judapies/Cabina-PCR/2019/CPCR 90 Artilab #004587978 OP201988/Schematic/Cabina_PCR - CADCAM Bottom Solder Resist.TXT

G04 PROTEUS RS274X GERBER FILE*
%FSLAX24Y24*%
%MOIN*%
%ADD26R,0.0700X0.0700*%
%ADD13C,0.0700*%
%ADD18C,0.1000*%
%ADD27C,0.0900*%
%ADD31R,0.1200X0.0800*%
%ADD28C,0.1500*%
%ADD29R,0.1000X0.1000*%
%ADD72C,0.2900*%
%ADD73R,0.2200X0.2200*%
%ADD32R,0.0850X0.1400*%
%ADD30C,0.1300*%
%ADD12C,0.0800*%
%ADD70C,0.0080*%
G54D26*
X+16102Y+9133D03*
G54D13*
X+17102Y+9133D03*
X+18102Y+9133D03*
X+19102Y+9133D03*
X+20102Y+9133D03*
X+21102Y+9133D03*
X+22102Y+9133D03*
X+23102Y+9133D03*
X+24102Y+9133D03*
X+25102Y+9133D03*
X+26102Y+9133D03*
X+27102Y+9133D03*
X+28102Y+9133D03*
X+29102Y+9133D03*
X+30102Y+9133D03*
X+31102Y+9133D03*
X+32102Y+9133D03*
X+33102Y+9133D03*
X+34102Y+9133D03*
X+35102Y+9133D03*
X+35102Y+15133D03*
X+34102Y+15133D03*
X+33102Y+15133D03*
X+32102Y+15133D03*
X+31102Y+15133D03*
X+30102Y+15133D03*
X+29102Y+15133D03*
X+28102Y+15133D03*
X+27102Y+15133D03*
X+26102Y+15133D03*
X+25102Y+15133D03*
X+24102Y+15133D03*
X+23102Y+15133D03*
X+22102Y+15133D03*
X+21102Y+15133D03*
X+20102Y+15133D03*
X+19102Y+15133D03*
X+18102Y+15133D03*
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
