judapies/Cabina-PCR/2019/CPCR 90 Artilab #004587978 OP201988/Materiales/Listado de Componentes Cabina de Flujo.xlsx

Sheet: Parte Electronica 110V
Cabina Flujo Vertical 110V
Descripción | Referencia | Cantidad | Sitio de Compra | Dirección
OptoTriac | MOC3041 | 3 | Sanyvi Electronics | Cra 9 # 19-30 LOC:212
Triac | BTA-16 | 3 | Sanyvi Electronics | Cra 9 # 19-30 LOC:212
Borneras | 2 Pines Verdes | 5 | Sanyvi Electronics | Cra 9 # 19-30 LOC:212
Conectores GP (con uñas) | 8 Pines | 1 | Sanyvi Electronics | Cra 9 # 19-30 LOC:212
 | 16 Pines | 2 | Sanyvi Electronics | Cra 9 # 19-30 LOC:212
Fusible Corto | 2 A. | 1 | Sanyvi Electronics | Cra 9 # 19-30 LOC:212
Portafusible pequeño para impreso | Con tapa negra | 1 | Sanyvi Electronics | Cra 9 # 19-30 LOC:212
Reostato | 10K | 1 | Sanyvi Electronics | Cra 9 # 19-30 LOC:212
Cristal de Cuarzo | 4MHz | 1 | Sanyvi Electronics | Cra 9 # 19-30 LOC:212
Resistencias 1/4W | 10K | 6 | Sanyvi Electronics | Cra 9 # 19-30 LOC:212
 | 1K | 5 | Sanyvi Electronics | Cra 9 # 19-30 LOC:212
 | 330R | 3 | Sanyvi Electronics | Cra 9 # 19-30 LOC:212
Condensador | 10uF/16V | 1 | Sanyvi Electronics | Cra 9 # 19-30 LOC:212
 | 100nF (104) Monolitico | 1 | Sanyvi Electronics | Cra 9 # 19-30 LOC:212
 | 22pF | 2 | Sanyvi Electronics | Cra 9 # 19-30 LOC:212
Display LCD | 4X20 Azul | 1 | Sanyvi Electronics | Cra 9 # 19-30 LOC:212
Varistor | 20D241K | 1 | Sanyvi Electronics | Cra 9 # 19-30 LOC:212
Microcontrolador | PIC 18F4550 | 1 | Sanyvi Electronics | Cra 9 # 19-30 LOC:212
Regleta Profesional | 40 pines | 3 | Sanyvi Electronics | Cra 9 # 19-30 LOC:212
Poste plastico | Para sujecion de tarjeta | 4 | Sanyvi Electronics | Cra 9 # 19-30 LOC:212
Botones | Tipo huevo blanco | 4 | Sanyvi Electronics | Cra 9 # 19-30 LOC:212
Transistor | 2N3904 | 1 | Sanyvi Electronics | Cra 9 # 19-30 LOC:212
Led Rojo | 5mm | 1 | Sanyvi Electronics | Cra 9 # 19-30 LOC:212
Buzzer redondo para impreso | 5V | 1 | Sanyvi Electronics | Cra 9 # 19-30 LOC:212
Interruptor ON-OFF redondo | 20mm Negro sin piloto | 1 | Sanyvi Electronics | Cra 9 # 19-30 LOC:212
Fuente 5VDC 4A Para impreso | IRM-20-5 | 1 | Sigma Electronica Ltda | Av. Cra 24 No 61D-65

Sheet: Parte Electrica 110V
Cabina Flujo Horizontal 110V
Descripción | Referencia | Cantidad | Precio Unitario | Precio Total
Breaker CHINT 1 polo | 2A | 1 | $10000 | $10000
Interruptor de balancin redondo | 20mm | 1 | $3000 | $3000
Regleta de polietileno | 30A | 1 | $4500 | $4500
Prensacable | PG11 | 4 | $800 | $3200
Cable Encauchetado Conalcables | 3X12 | 4 | $4500 | $18000
Clavija | 110V 15A Leviton | 1 | $6500 | $6500
 |  |  |  | $45200 | TOTAL

Sheet: Hoja1
 | Cabina Flujo Vertical 220V
 | Descripción | Referencia | Cantidad
 | OptoTriac | MOC3021 | 6
 | Triac | BT137 | 2
 |  | BTA-16 | 4
 | Borneras | 2 Pines Verdes | 7
 |  | 3 Pines Verde | 1
 | Conectores GP (con uñas) | 5 Pines | 1
 |  | 16 Pines | 2
 | Puente Rectificador | Redondo 1A | 1
 | Regulador de Voltaje | LM7805 | 1
 | Reostato | 10K | 1
 | Cristal de Cuarzo | 4MHz | 1
 | Resistencias 1/4W | 10K | 6
 |  | 1K | 6
 |  | 330R | 6
 | Condensador | 470uF/25V | 1
 |  | 10uF/16V | 3
 |  | 100nF (104) | 2
 |  | 22pF | 2
 | Display | 4X20 | 1
 | Microcontrolador | PIC 18F4550 | 1
 | Terminales | Según muestra | 8
 | Breaker CHINT 2 polos | 2A | 1
 | Breaker CHINT 1 polo | 10A | 1
 | Interruptor de balancin redondo | 20mm | 1
 | Toma doble blanca | Leviton | 1
 | Tapa de seguridad para toma doble | Plastica gris | 1
 | Regleta de polietileno | 15A | 1
 | Prensacable | PG11 | 4
 | Cable Encauchetado Conalcables | 4X12 | 3m
Ingenieros | Faiver H. Trujillo G | Juan David Piñeros E | 2014- Abr-15
