judapies/Cabina-PCR/2019/CPCR 90 Artilab #004587978 OP201988/SGC/REQUISICION DE MATERIALES CABINA DE FLUJO LAMINAR HORIZONTAL.xlsx

Sheet: Formato requisiones
JP BIOINGENIERIA S.A.S |  |  | REQUISICION DE MATERIALES |  |  |  |  |  |  |  | FJP - 35
 |  |  |  |  |  |  |  |  |  |  | Version 01
Efectivo a partir de: 20 Dic 2017 |  |  |  |  |  | Documento de origen: DJP- 24 |  |  |  |  | Pág. 1 de 1
FECHA | 10 | 7 | 2019
PRODUCTO: | CABINA DE PCR 90 |  |  |  |  |  |  | Orden de Pedido No. |  |  | 201988
 |  |  |  |  |  |  |  | Visita Técnica:
DESCRIPCION |  |  |  |  |  | Referencia |  |  | CANTIDAD REQUERIDA
Tarjeta PCR |  |  |  |  |  | DIELEC |  |  | 1
FUENTE DE PODER |  |  |  |  |  | IRM 20-5 |  |  | 1
Resistencias (1/4W) |  |  |  |  |  | 10K |  |  | 6
Resistencias (1/4W) |  |  |  |  |  | 330Ω |  |  | 3
Resistencias (1/4W) |  |  |  |  |  | 1K | 1K | 1K | 5 | 10 | 10 | 10
Reóstato | Reóstato | Reóstato | Reóstato | Reóstato | Reóstato | 10K (pequeño) | 10K (pequeño) | 10K (pequeño) | 1 | 2 | 2 | 2
Condensadores | Condensadores | Condensadores | Condensadores | Condensadores | Condensadores | Condensador 104 tantalio | 0.1 uF Monolitico | 0.1 uF Monolitico | 1 | 28 | 28 | 28
Condensadores | Condensadores | Condensadores | Condensadores | Condensadores | Condensadores | 22 pF Ceramico | 22 pF Ceramico | 22 pF Ceramico | 2 | 4 | 4 | 4
Buzzer | Condensadores | Condensadores | Condensadores | Condensadores | Condensadores | 5 a 12v | 470 µF @ 16V | 470 µF @ 16V | 1 | 2 | 2 | 2
Condensadores | Condensadores | Condensadores | Condensadores | Condensadores | Condensadores | 10 µF @ 16V | 10 µF @ 16V | 10 µF @ 16V | 1 | 2 | 2 | 2
Cristal | Cristal | Cristal | Cristal | Cristal | Cristal | 4MHz | 4MHz | 4MHz | 1 | 2 | 2 | 2
Pantalla LCD. Azul | Pantalla LCD. Azul | Pantalla LCD. Azul | Pantalla LCD. Azul | Pantalla LCD. Azul | Pantalla LCD. Azul | 4X20 | 2X16 | 2X16 | 1 | 2 | 2 | 2
Conector GP (Con uñas) | Conector GP (Con uñas) | Conector GP (Con uñas) | Conector GP (Con uñas) | Conector GP (Con uñas) | Conector GP (Con uñas) | 16P | 2P | 2P | 2 | 4 | 4 | 4
Conector GP (Con uñas) | Conector GP (Con uñas) | Conector GP (Con uñas) | Conector GP (Con uñas) | Conector GP (Con uñas) | Conector GP (Con uñas) | 8P | 3P | 3P | 1 | 6 | 6 | 6
Regleta profesional | Regleta profesional | Regleta profesional | Regleta profesional | Regleta profesional | Regleta profesional | 1X40 | 1X40 | 1X40 | 1 | 2 | 2 | 2
Transistor | Transistor | Transistor | Transistor | Transistor | Transistor | 2N3904 | 2N3904 | 2N3904 | 1 | 2 | 2 | 2
Bornera | Bornera | Bornera | Bornera | Bornera | Bornera | 2 pines Verde | 2 pines Verde | 2 pines Verde | 5 | 2 | 2 | 2
Botones | Botones | Botones | Botones | Botones | Botones | Tipo huevo blanco | Tipo huevo blanco | Tipo huevo blanco | 4 | 6 | 6 | 6
Led para piloto 5mm | Led para piloto 5mm | Led para piloto 5mm | Led para piloto 5mm | Led para piloto 5mm | Led para piloto 5mm | Rojo | Chorro | Chorro | 1 | 2 | 2 | 2
Interruptor redondo | Interruptor redondo | Interruptor redondo | Interruptor redondo | Interruptor redondo | Interruptor redondo | on/off | con piloto | con piloto | 1 | 2 | 2 | 2
Portafusible Corto | Portafusible largo | Portafusible largo | Portafusible largo | Portafusible largo | Portafusible largo | para impreso | Para Chasis | Para Chasis | 1 | 2 | 2 | 2
fusible | fusible | fusible | fusible | fusible | fusible | 2A | 250 mA | 250 mA | 1 | 2 | 2 | 2
Optocoplador | Conector DB25 para impreso | Conector DB25 para impreso | Conector DB25 para impreso | Conector DB25 para impreso | Conector DB25 para impreso | MOC 3041 | Macho | Macho | 3 | 2 | 2 | 2
Triac | Extensión DB25 | Extensión DB25 | Extensión DB25 | Extensión DB25 | Extensión DB25 | BT137 | Macho-Hembra | Macho-Hembra | 3 | 2 | 2 | 2
Sensor de presion | Puntas de Multímetro | Puntas de Multímetro | Puntas de Multímetro | Puntas de Multímetro | Puntas de Multímetro | MPXV5004DP | Negras | Negras | 1 | 2 | 2 | 2
Switch Magnetico Blanco | Puntas de Multímetro | Puntas de Multímetro | Puntas de Multímetro | Puntas de Multímetro | Puntas de Multímetro | Con iman | Negras | Negras | 1 | 2 | 2 | 2
Breaker chint un polo | Bananas para puntas | Bananas para puntas | Bananas para puntas | Bananas para puntas | Bananas para puntas | 10A | Negras | Negras | 1 | 4 | 4 | 4
Contactor chint | Banana Negra | Banana Negra | Banana Negra | Banana Negra | Banana Negra | 9A | Hembra | Hembra | 1 | 2 | 2 | 2
Clavija levinton amarilla | Conector USB TipoB | Conector USB TipoB | Conector USB TipoB | Conector USB TipoB | Conector USB TipoB | 15A 125V | Pines atrás | Pines atrás | 1 | 2 | 2 | 2
Microcontrolador | Microcontrolador | Microcontrolador | Microcontrolador | Microcontrolador | Microcontrolador | PIC 18F4550 | PIC 18F4550 | PIC 18F4550 | 1 | 2 | 2 | 2
Poste plastico | Poste plastico | Poste plastico | Poste plastico | Poste plastico | Poste plastico | Para sujecion de tarjeta | Para sujecion de tarjeta | Para sujecion de tarjeta | 4 | 8 | 8 | 8
Toma Doble 110V |  |  |  |  |  | Hidrobox |  |  | 2
Luz UV |  |  |  |  |  | 15W |  |  | 2
Luces |  |  |  |  |  | Led blanca |  |  | 1
Balastro |  |  |  |  |  | 2X32W ;120-227V |  |  | 1
CANALETA |  |  |  |  |  | CANALETA RANURADA |  |  | 1MT
Frenos | PortaLED | PortaLED | PortaLED | PortaLED | PortaLED | Frenos riel omega | Para LED de 5mm | Para LED de 5mm | 2 | 10 | 10 | 10
CABLE |  |  |  |  |  | CABLE 8X22 |  |  | 1,30MTS
CABLE VEHICULAR L Y N |  |  |  |  |  | CABLE #18 |  |  | 60 CMS
CABLE VEHICULAR L Y N |  |  |  |  |  | CABLE #18 |  |  | 1 MTS
CABLE VEHICULAR L Y N |  |  |  |  |  | CABLE #18 |  |  | 1,10MTS
CABLE |  |  |  |  |  | CABLE 2X18 |  |  | 1,15MTS
CABLE |  |  |  |  |  | CABLE 16X22 |  |  | 1,30 MTS
CABLE |  |  |  |  |  | CABLE 3X14 |  |  | 6 MTS
TERMINALES |  |  |  |  |  | Tipo O amarilla |  |  | 2
TERMINALES |  |  |  |  |  | Tipo fastor azul |  |  | 2
TERMINALES |  |  |  |  |  | Tipo bala hembra azul |  |  | 2
TERMINALES |  |  |  |  |  | Tipo bala macho azul |  |  | 2
TERMINALES |  |  |  |  |  | Tipo bala hembra rojas |  |  | 10
TERMINALES |  |  |  |  |  | Tipo bala macho rojas |  |  | 10
Caja de Paso Plastica |  |  |  |  |  | K2121-116 |  |  | 0
Riel omega |  |  |  |  |  | Riel |  |  | 10 cm
SOLICITADO POR: |  |  |  | ENTREGADO POR: |  |  |  | RECIBIDO POR:

Sheet: Informe de compatibilidad
Informe de compatibilidad para FJP- 35 REQUISICION DE MATERIALES.XLS
Ejecutar el 10/05/2018 8:41
Las siguientes características de este libro no son compatibles con versiones anteriores de Excel. Estas características podrían perderse o degradarse si abre el libro con una versión anterior de Excel o si guarda el libro con un formato de archivo anterior.
Pérdida menor de fidelidad | Nº de apariciones | Versión
Algunas celdas o estilos de este libro contienen un formato no admitido en el formato de archivo seleccionado. Estos formatos se convertirán al formato más cercano disponible. | 1 | Excel 97-2003
