judapies/Cabina-PCR/2019/CPCR60 GLCD Avantika  #004588033-40 OP2019156-161_181-182/SGC/FJP- 35  REQUISICION DE MATERIALES CFLH-V GLCD.xlsx

JP BIOINGENIERIA S.A.S |  |  | REQUISICION DE MATERIALES |  |  |  |  |  |  |  | FJP - 35
 |  |  |  |  |  |  |  |  |  |  | Version 01
Efectivo a partir de: 20 Dic 2017 |  |  |  |  |  | Documento de origen: DJP- 24 |  |  |  |  | Pág. 1 de 1
FECHA | 13 | 11 | 2019
PRODUCTO: | CPCR24 |  |  |  |  |  |  | Orden de Pedido No.
 |  |  |  |  |  |  |  | Visita Técnica:
DESCRIPCION |  |  |  |  |  | Referencia |  |  | CANTIDAD REQUERIDA
Tarjeta de control |  |  |  |  |  | DIELEC-CFLH-V0015 |  |  | 1
Resistencias Montaje Superficial 0805 |  |  |  |  |  | 470Ω |  |  | 1
Resistencias Montaje Superficial 0805 |  |  |  |  |  | 10k |  |  | 7
Resistencias Montaje Superficial 0805 |  |  |  |  |  | 1k |  |  | 6
Resistencias (1W) |  |  |  |  |  | 15k |  |  | 2
Resistencias (1W) |  |  |  |  |  | 39Ω |  |  | 1
Resistencias (1W) |  |  |  |  |  | 360Ω |  |  | 1
Resistencias (1W) |  |  |  |  |  | 470Ω |  |  | 1
Condensador de Poliester | Reóstato | Reóstato | Reóstato | Reóstato | Reóstato | 103/600V | 10K (pequeño) | 10K (pequeño) | 1 | 2 | 2 | 2
Condensador de Poliester | Reóstato | Reóstato | Reóstato | Reóstato | Reóstato | 50nF/600V | 10K (pequeño) | 10K (pequeño) | 1 | 2 | 2 | 2
Condensador de tantalio SMD | Condensadores | Condensadores | Condensadores | Condensadores | Condensadores | 0,1uF | 10 µF @ 16V | 10 µF @ 16V | 5
Condensador Ceramico | Condensadores | Condensadores | Condensadores | Condensadores | Condensadores | 22pF | 10 µF @ 16V | 10 µF @ 16V | 2
Cristal de Quarzo | Cristal | Cristal | Cristal | Cristal | Cristal | 20MHz | 4MHz | 4MHz | 1
Regleta Macho | Conector GP (Con uñas) | Conector GP (Con uñas) | Conector GP (Con uñas) | Conector GP (Con uñas) | Conector GP (Con uñas) | 1X40 | 2P | 2P | 1
Conector GP (Con uñas) | Conector GP (Con uñas) | Conector GP (Con uñas) | Conector GP (Con uñas) | Conector GP (Con uñas) | Conector GP (Con uñas) | 8P | 5P | 5P | 1
Regleta Hembra | Conector GP (Con uñas) | Conector GP (Con uñas) | Conector GP (Con uñas) | Conector GP (Con uñas) | Conector GP (Con uñas) | 1x40 | 5P | 5P | 1
Regleta profesional | Regleta profesional | Regleta profesional | Regleta profesional | Regleta profesional | Regleta profesional | 1X40 | 1X40 | 1X40 | 2
Optocoplador |  |  |  |  |  | MOC3021 |  |  | 1
Triac |  |  |  |  |  | BT139 |  |  | 1
Transistor Montaje Superficial |  |  |  |  |  | MMBT2222A |  |  | 4
Puente Rectificador Montaje Superficial |  |  |  |  |  | DF02S |  |  | 1
Elevador de Voltaje | Regulador 5V | Regulador 5V | Regulador 5V | Regulador 5V | Regulador 5V | MT3608 | LM 7805 | LM 7805 | 0
Fuente Conmutada para PCB | Puente Rectificador | Puente Rectificador | Puente Rectificador | Puente Rectificador | Puente Rectificador | IRM-20-5 | Redondo 1.5A | Redondo 1.5A | 1 | 2 | 2 | 2
Interruptor Redondo | Puente Rectificador | Puente Rectificador | Puente Rectificador | Puente Rectificador | Puente Rectificador | ON-OFF Negro | Redondo 1.5A | Redondo 1.5A | 1 | 2 | 2 | 2
Borneras | Bornera | Bornera | Bornera | Bornera | Bornera | 2 pines Verde | 2 pines Verde | 2 pines Verde | 9 | 2 | 2 | 2
Botones | Botones | Botones | Botones | Botones | Botones | Tipo huevo blanco | Tipo huevo blanco | Tipo huevo blanco | 4 | 6 | 6 | 6
Sensor de Presion | Botones | Botones | Botones | Botones | Botones | MPXV5004DP | Tipo huevo blanco | Tipo huevo blanco | 1 | 6 | 6 | 6
Buzzer | Buzzer | Buzzer | Buzzer | Buzzer | Buzzer | 5V ó 12V | 5V a 12V | 5V a 12V | 1 | 2 | 2 | 2
Diodo Montaje Superficial |  |  |  |  |  | FM4004 |  |  | 1
Led 0805 |  |  |  |  |  | Rojo o Verde o Azul |  |  | 1
Disipador con pines para soldar |  |  |  |  |  | Grande |  |  | 1
Reostato pequeño |  |  |  |  |  | 10k |  |  | 1
Portafusible para impreso |  |  |  |  |  | Con Tapa |  |  | 1
Fusible Corto |  |  |  |  |  | 4A |  |  | 1
Microcontrolador | Microcontrolador | Microcontrolador | Microcontrolador | Microcontrolador | Microcontrolador | PIC 18F4685 | PIC 18F4550 | PIC 18F4550 | 1 | 2 | 2 | 2
Display GLCD | Microcontrolador | Microcontrolador | Microcontrolador | Microcontrolador | Microcontrolador | 128x64 px Azul | PIC 18F4550 | PIC 18F4550 | 1 | 2 | 2 | 2
Switch Magnetico |  |  |  |  |  | Para posicion de Vidrio |  |  | 1
Iman para Switch Magnetico |  |  |  |  |  | Para posicion de Vidrio |  |  | 1
Optocoplador |  |  |  |  |  | PC817 |  |  | 1
Rele de Estadoo Solido para impreso |  |  |  |  |  | G3MB-202P |  |  | 1
Sensor de Temperatura |  |  |  |  |  | LM35 |  |  | 1
Breaker unipolar CHINT 4A |  |  |  |  |  | 09606 |  |  | 1
Breaker unipolar CHINT 10A |  |  |  |  |  | 09610 |  |  | 1
Riel |  |  |  |  |  | Omega |  |  | 15cm
Frenos para riel omega |  |  |  |  |  |  |  |  | 2
Pasacable |  |  |  |  |  | PG11
Pasacable |  |  |  |  |  | PG13,5
Clavija Leviton Amarilla |  |  |  |  |  | 115VAC/15A |  |  | 1
Toma |  |  |  |  |  | Hidrobox |  |  | 2
Modulo |  |  |  |  |  | Hidrobox |  |  | 2
Terminal |  |  |  |  |  | Tipo Bala hembra (roja)
Terminal |  |  |  |  |  | Tipo Bala Macho(roja)
Terminal |  |  |  |  |  | Tipo Bala hembra (Azul)
Terminal |  |  |  |  |  | Tipo Bala Macho (Azul)
Terminal |  |  |  |  |  | Tipo ojo (Amarilla)
Terminal |  |  |  |  |  | Tipo Faston (Azul)
Bornera plastica |  |  |  |  |  | 15A
Luz led |  |  |  |  |  |  |  |  | 2
Luz UV Germicida |  |  |  |  |  | 15W |  |  | 2
Balastro Multivoltaje |  |  |  |  |  | 2X32W |  |  | 1
Cable (sensor flujo) |  |  |  |  |  | Blindado 6x22
Cable (sensor vidrio) |  |  |  |  |  | Blindado 6x22
Cable (Botones) |  |  |  |  |  | Blindado 8x22
Cable (toma) |  |  |  |  |  | Encauchetado 3x14
Cable (Alimentacion) |  |  |  |  |  | Encauchetado 3x14
Cable (Motores) |  |  |  |  |  | Encauchetado 3x18
Cable (Luz blanca) |  |  |  |  |  | Encauchetado 2x18
Cable (Luz UV) |  |  |  |  |  | Encauchetado 2x18
SOLICITADO POR: |  |  |  | ENTREGADO POR: |  |  |  | RECIBIDO POR:
