judapies/Cabina-PCR/2017/60/Cabina Avantika #004587687/Schematic/Cabina_PCR.DXF

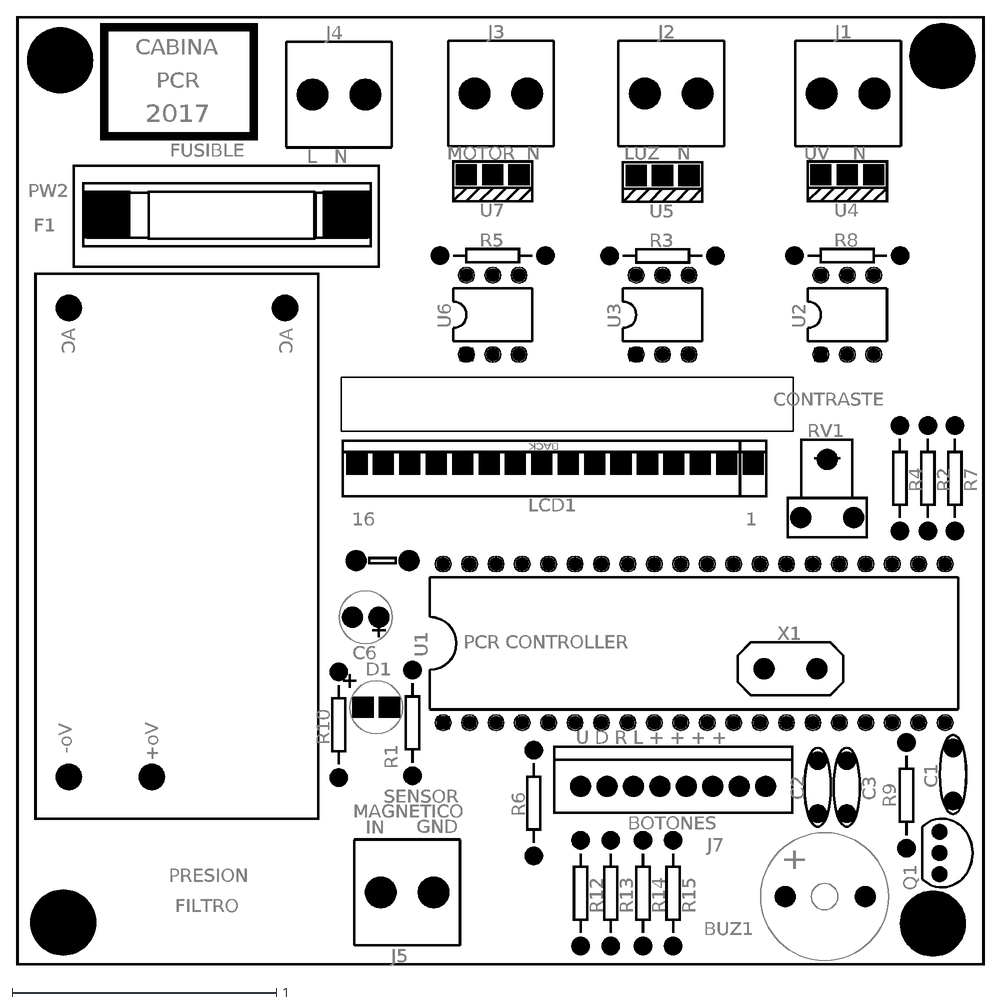
[picture p1: CAD file, 2021-07-15]
2017/60/Cabina Avantika #004587687/Schematic/Cabina_PCR.DXF
U1
J7
R12
R13
R14
R15
R6
J5
R1
C1
BACK
LCD1
RV1
X1
C2
C3
J4
R7
R2
R3
R4
U2
U3
U6
R8
R5
U4
U5
U7
J1
J2
J3
F1
CABINA
PCR
2017
C6
AC
Vo+
Vo-
PW2
PCR CONTROLLER
BOTONES
U D R L + + + +
SENSOR
MAGNETICO
IN
GND
PRESION
FILTRO
1
16
CONTRASTE
FUSIBLE
L N
MOTOR N
UV N
LUZ N
+
BUZ1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
