judapies/Cabina-PCR/2019/CPCR 90 Universidad Nariño LCD4X20 #004588059 OP2019205/Schematic/User Library-LCD 4X20.IGS

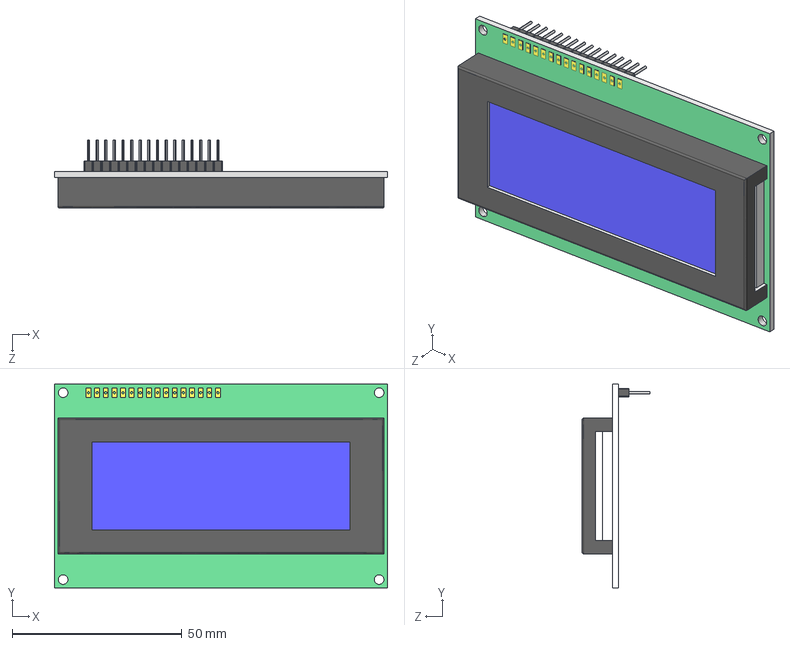
[picture p2: CAD file, 2021-07-15]
2019/CPCR 90 Universidad Nariño LCD4X20 #004588059 OP2019205/Schematic/User Library-LCD 4X20.IGS
98.0 x 60.0 x 20.0 mm
