judapies/Cabina-PCR/(list of files, cad)

Other CAD files:
2015/Microvet/Plano Electrico/Mini-Cabina 110VAC/Distribucion de conexiones.dwg
2015/Microvet/Plano Electrico/Plano_Electrico_Cabina_Flujo_Vertical/Distribución de Conexiones.dwg
2017/60/Cabina Avantika #004587687/Plano Electrico/Plano Electrico Cabina PCR/ConexionesElectricasYElectronicas.dwg
2017/60/Cabina Punto Clinico #004587647/Plano Electrico/Plano Electrico Cabina PCR/ConexionesElectricasYElectronicas.dwg
2019/CPCR 90 Artilab #004587978 OP201988/Plano Electrico/Plano Electrico Cabina CFLH/ConexionesElectricasYElectronicas.dwg
2019/CPCR 90 Artilab #004587987 OP201994/Plano Electrico/Plano Electrico Cabina CFLH/ConexionesElectricasYElectronicas.dwg
2019/CPCR 90 Universidad Nariño LCD4X20 #004588059 OP2019205/Plano Electrico/Plano Electrico Cabina CFLH/ConexionesElectricasYElectronicas.dwg
2019/CPCR60 GLCD Avantika #004588033-40 OP2019156-161_181-182/Plano Electrico CPCR GLCD/Conexiones_Panel_Control CPCR.dwg
2019/CPCR90 GLCD Artilab #004587996 OP2019116/Plano Electrico CPCR GLCD/Conexiones_Panel_Control CPCR.dwg
2020/CPCR 48 Laboratorio Garcia Beltran LCD4X20 #004588177 OP202083/Plano Electrico/Plano Electrico Cabina CFLH/ConexionesElectricasYElectronicas.dwg
2020/CPCR Trabajo Annar D4X20 #004588213-14-36-37 OP2020200-203/Plano Electrico/Plano Electrico Estacion PCR/ConexionesElectricasYElectronicas.dwg
2020/CPCR Trabajo Annar D4X20 #004588267-68-69-70-71-72-73 OP2020231-232-233-234-235-244-245/Plano Electrico/Plano Electrico Estacion PCR/ConexionesElectricasYElectronicas.dwg
2020/CPCR Trabajo Annar D4X20 #0045882XX-XX-XX-XX-XX OP2020265-266-267-268-269/Plano Electrico/Plano Electrico Estacion PCR/ConexionesElectricasYElectronicas.dwg
2020/CPCR Trabajo Artilab D4X20 #004588179 OP2020157/Plano Electrico/Plano Electrico Estacion PCR/ConexionesElectricasYElectronicas.dwg
2020/CPCR Trabajo Avantika D4X20 #0045882XX-XX OP2020226-227/Plano Electrico/Plano Electrico Estacion PCR/ConexionesElectricasYElectronicas.dwg
2020/CPCR Trabajo Avantika D4X20 #004588337-48 OP2020305-306/Plano Electrico/Plano Electrico Estacion PCR/ConexionesElectricasYElectronicas.dwg
2020/CPCR Trabajo Biodiz D4X20 #004588392 OP2020357/Plano Electrico/Plano Electrico Estacion PCR/ConexionesElectricasYElectronicas.dwg
2020/CPCR Trabajo Clinica Los Nogales D4X20 #004588205 OP2020163/Plano Electrico/Plano Electrico Estacion PCR/ConexionesElectricasYElectronicas.dwg
2020/CPCR Trabajo Colcan D4X20 #004588219-20-21-22-23-24 OP2020186-91/Plano Electrico/Plano Electrico Estacion PCR/ConexionesElectricasYElectronicas.dwg
2020/CPCR Trabajo Colcan D4X20 #0045882XX-XX-XX-XX-XX OP2020265-266-267-268-269 - copia/Plano Electrico/Plano Electrico Estacion PCR/ConexionesElectricasYElectronicas.dwg
2020/CPCR Trabajo Kasai D4X20 #004588185 OP2020164/Plano Electrico/Plano Electrico Estacion PCR/ConexionesElectricasYElectronicas.dwg
2020/CPCR Trabajo Laboratorio Hormonal D4X20 #004588180 OP2020160/Plano Electrico/Plano Electrico Estacion PCR/ConexionesElectricasYElectronicas.dwg
2020/CPCR Trabajo Labserving D4X20 #0045882XX OP2020223/Plano Electrico/Plano Electrico Estacion PCR/ConexionesElectricasYElectronicas.dwg
2020/CPCR Trabajo Lorena Vejarano D4X20 #004588135 OP2020109/Plano Electrico/Plano Electrico Estacion PCR/ConexionesElectricasYElectronicas.dwg
2020/CPCR Trabajo Lorena Vejarano D4X20 #004588136 OP2020110/Plano Electrico/Plano Electrico Estacion PCR/ConexionesElectricasYElectronicas.dwg
2020/CPCR Trabajo Lorena Vejarano D4X20 #004588210 OP2020180/Plano Electrico/Plano Electrico Estacion PCR/ConexionesElectricasYElectronicas.dwg
2020/CPCR Trabajo Lorena Vejarano D4X20 #004588211 OP2020179/Plano Electrico/Plano Electrico Estacion PCR/ConexionesElectricasYElectronicas.dwg
2020/CPCR Trabajo Prime Diagnostics D4X20 #004588391-57 OP2020348-349/Plano Electrico/Plano Electrico Estacion PCR/ConexionesElectricasYElectronicas.dwg
2020/CPCR180 GLCD Diagnostic Medical Lab #004588393 OP2020308/Plano Electrico CPCR GLCD/Conexiones_Panel_Control CPCR.dwg
2020/CPCR60 GLCD Laboratorio Clinico Kheneyder Fayad #004588294 OP2020276/Plano Electrico CPCR GLCD/Conexiones_Panel_Control CPCR.dwg
2020/CPCR60 GLCD Avantika #004588102 OP202046/Plano Electrico CPCR GLCD/Conexiones_Panel_Control CPCR.dwg
2020/CPCR60 GLCD Avantika #004588103 OP202047/Plano Electrico CPCR GLCD/Conexiones_Panel_Control CPCR.dwg
2020/CPCR60 GLCD Avantika #004588100 OP202044/Plano Electrico CPCR GLCD/Conexiones_Panel_Control CPCR.dwg
2020/CPCR60 GLCD Avantika #004588101 OP202045/Plano Electrico CPCR GLCD/Conexiones_Panel_Control CPCR.dwg
2020/CPCR60 GLCD CEMMIT #004588404 OP2020359/Plano Electrico CPCR GLCD/Conexiones_Panel_Control CPCR.dwg
2020/CPCR90 GLCD Artilab #004588091 OP2019199/Plano Electrico CPCR GLCD/Conexiones_Panel_Control CPCR.dwg
2020/CPCR90 GLCD Avantika #004588183 OP2020140/Plano Electrico CPCR GLCD/Conexiones_Panel_Control CPCR.dwg
2020/CPCR90 GLCD Avantika #004588186-87 OP2020154-155/Plano Electrico CPCR GLCD/Conexiones_Panel_Control CPCR.dwg
2020/CPCR90 GLCD Avantika #004588212 OP2020170/Plano Electrico CPCR GLCD/Conexiones_Panel_Control CPCR.dwg
2020/CPCR90 GLCD Avantika #004588258 OP2020211/Plano Electrico CPCR GLCD/Conexiones_Panel_Control CPCR.dwg
2020/CPCR90 GLCD Biodiz Peru #004588195 OP2020149/Plano Electrico CPCR GLCD/Conexiones_Panel_Control CPCR.dwg
2020/CPCR90 GLCD Biodiz Peru #004588196 OP2020150/Plano Electrico CPCR GLCD/Conexiones_Panel_Control CPCR.dwg
2020/CPCR90 GLCD Biodiz Peru #004588396 OP2020356/Plano Electrico CPCR GLCD/Conexiones_Panel_Control CPCR.dwg
2020/CPCR90 GLCD CEMMIT #004588354 OP2020304/Plano Electrico CPCR GLCD/Conexiones_Panel_Control CPCR.dwg
2020/CPCR90 GLCD Ghesminne Ortega Peru #004588231 OP2020195/Plano Electrico CPCR GLCD/Conexiones_Panel_Control CPCR.dwg
2020/CPCR90 GLCD Sin Cliente #0045883XX OP2020XXX/Plano Electrico CPCR GLCD/Conexiones_Panel_Control CPCR.dwg
2021/JP24-PCR D4X20 Annar #004588490 OP202151/Plano Electrico/Plano Electrico Estacion PCR/ConexionesElectricasYElectronicas.dwg
2021/JP24-PCR D4X20 Annar #004588572 OP202178/Plano Electrico/Plano Electrico Estacion PCR/ConexionesElectricasYElectronicas.dwg
2021/JP24-PCR D4X20 Annar #004588573 OP202179/Plano Electrico/Plano Electrico Estacion PCR/ConexionesElectricasYElectronicas.dwg
2021/JP24-PCR D4X20 Annar #004588603-04 OP2021111-112/Plano Electrico/Plano Electrico Estacion PCR/ConexionesElectricasYElectronicas.dwg
2021/JP24-PCR D4X20 Annar #004588620-21-30-31-32 OP2021125-126-144-145-146/Plano Electrico/Plano Electrico Estacion PCR/ConexionesElectricasYElectronicas.dwg
2021/JP24-PCR D4X20 Annar #0045886XX-XX-XX OP2021162-163-164/Plano Electrico/Plano Electrico Estacion PCR/ConexionesElectricasYElectronicas.dwg
2021/JP24-PCR GLCD Bioweb #004588574-75 OP202188-89/Plano Electrico CPCR GLCD/Conexiones_Panel_Control CPCR.dwg
2021/JP24-PCR GLCD Humalib #004588469 OP202131/Plano Electrico CPCR GLCD/Conexiones_Panel_Control CPCR.dwg
2021/JP24-PCR GLCD Hydrochem #004588586 OP202184/Plano Electrico CPCR GLCD/Conexiones_Panel_Control CPCR.dwg
2021/JP24-PCR GLCD Sin Cliente #004588596 OP2021XX/Plano Electrico CPCR GLCD/Conexiones_Panel_Control CPCR.dwg
2021/JP24-PCR80 D4X20 Avantika #004588513 OP202123/Plano Electrico/Plano Electrico Estacion PCR/ConexionesElectricasYElectronicas.dwg
2021/JP24-PCR80 D4X20 Avantika #004588514 OP202128/Plano Electrico/Plano Electrico Estacion PCR/ConexionesElectricasYElectronicas.dwg
2021/JP24-PCR80 D4X20 Avantika #004588515 OP202127/Plano Electrico/Plano Electrico Estacion PCR/ConexionesElectricasYElectronicas.dwg
2021/JP24-PCR80 D4X20 Avantika #004588516 OP202126/Plano Electrico/Plano Electrico Estacion PCR/ConexionesElectricasYElectronicas.dwg
2021/JP24-PCR80 D4X20 Avantika #004588517 OP202125/Plano Electrico/Plano Electrico Estacion PCR/ConexionesElectricasYElectronicas.dwg
2021/JP24-PCR80 D4X20 Avantika #004588518 OP202124/Plano Electrico/Plano Electrico Estacion PCR/ConexionesElectricasYElectronicas.dwg
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
