judapies/Cabina-PCR/2019/CPCR60 GLCD Avantika  #004588033-40 OP2019156-161_181-182/Documentos/ManualPCR_2019.pdf

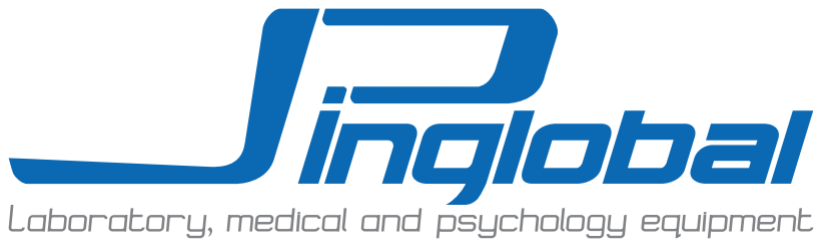
[picture p19: figure]

# MANUAL DE USUARIO

# JP – CABINA DE FLUJO LAMINAR PCR

JP BIOINGENIERÍA S.A.S.

Marca JP INGLOBAL REF. JPCV36-PCR-EC

MANUAL DE INSTRUCCIONES JP INGLOBAL CABINA DE FLUJO LAMINAR PCR

2

MANUAL DE USUARIO CABINA DE FLUJO LAMINAR PCR – JPCV36-PCR-EC

0Este documento contiene información confidencial perteneciente a JP BIOINGENIERÍA S.A.S, la misma constituye un secreto de industria, está siendo entregada para el uso adecuado de la máquina. De ninguna manera los asuntos descritos en este documento deben ser duplicados o usados en su totalidad ni en parte, para ningún propósito que

no sea el buen uso del equipo. Dudas o sugerencias, favor escribir a: servicioalcliente@jpinglobal.com y/o o comunicarse al Teléfono: +57 (1) 756-8668 / Cel.

+57 (1) 316-464-3827

## TABLA DE CONTENIDO

3

MANUAL DE USUARIO CABINA DE FLUJO LAMINAR PCR – JPCV36-PCR-EC

0Este documento contiene información confidencial perteneciente a JP BIOINGENIERÍA S.A.S, la misma constituye un secreto de industria, está siendo entregada para el uso adecuado de la máquina. De ninguna manera los asuntos descritos en este documento deben ser duplicados o usados en su totalidad ni en parte, para ningún propósito que

no sea el buen uso del equipo. Dudas o sugerencias, favor escribir a: servicioalcliente@jpinglobal.com y/o o comunicarse al Teléfono: +57 (1) 756-8668 / Cel.

“La información presentada en este Manual pertenece a título exclusivo y privativo a JP INGLOBAL, sin

que su publicación suponga, en modo alguno, que los elementos publicados o en la forma en la cual se

presentan, sea del dominio público. En consecuencia, queda terminantemente prohibida su reproducción, así

como la fabricación, comercialización y/o distribución o cualquier otra actividad que recaiga sobre los

elementos publicados, sin el expreso consentimiento escrito del representante legal de esta Compañía”.

El presente manual debe permanecer cerca del equipo para estar a disposición del operador ante cualquier

consulta. El equipo debe ser utilizado solo de acuerdo a lo establecido en este manual, el cual no puede ser

modificado bajo ningún concepto. En el caso de que el cliente necesite una nueva copia del manual deberá

ponerse en contacto con JPINGLOBAL Tel: 7568668.

JP INGLOBAL, se reserva el derecho de modificar, total o parcialmente, cualquiera de los datos y

especificaciones técnicas que aparecen en esta publicación.

Gracias por haber adquirido este Equipo Marca JP INGLOBAL. Para obtener el mejor rendimiento del

equipo por favor lea detenidamente estas instrucciones antes de utilizarlo.

Antes de desechar el embalaje asegúrese que se incluyen todas las piezas y que están en buen estado.

Para seguridad propia y de otros por favor lea y memorice el consejo de seguridad descrito a

continuación antes de utilizar el Instrumento y/o equipo.

4

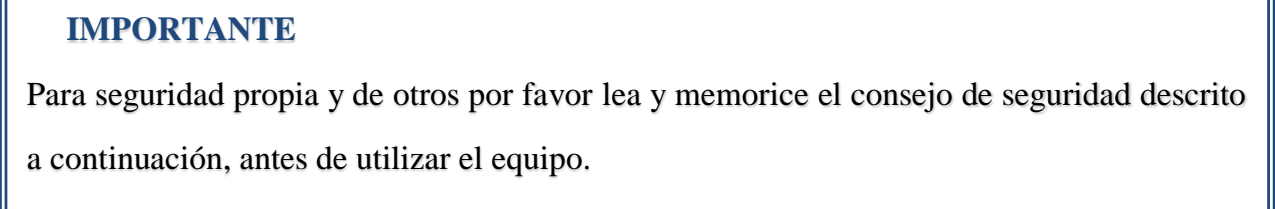
[picture p20: figure]
IMPORTANTE

MANUAL DE USUARIO CABINA DE FLUJO LAMINAR PCR – JPCV36-PCR-EC

0Este documento contiene información confidencial perteneciente a JP BIOINGENIERÍA S.A.S, la misma constituye un secreto de industria, está siendo entregada para el uso adecuado de la máquina. De ninguna manera los asuntos descritos en este documento deben ser duplicados o usados en su totalidad ni en parte, para ningún propósito que

no sea el buen uso del equipo. Dudas o sugerencias, favor escribir a: servicioalcliente@jpinglobal.com y/o o comunicarse al Teléfono: +57 (1) 756-8668 / Cel.

### 1. INTRODUCCIÓN

Apreciado cliente:

Gracias por haber adquirido este producto de calidad marca JP INGLOBAL.

Para obtener el mejor rendimiento del equipo rogamos lea detenidamente estas instrucciones antes de utilizarlo.

Para seguridad propia y de otros por favor lea y memorice el consejo de seguridad descrito

a continuación, antes de utilizar el equipo.

NOTA

Esta documentación está destinada exclusivamente a los compradores de nuestros productos

por lo que no puede ser reproducida, comunicada ni entregada a terceros sin previa

autorización escrita del representante legal. Derechos de propiedad intelectual JP

INGLOBAL tiene todos los derechos sobre gráficos y demás documentación, así como

sobre toda la capacidad de disposición, incluso en el caso de registro de derechos de

propiedad intelectual.

5

MANUAL DE USUARIO CABINA DE FLUJO LAMINAR PCR – JPCV36-PCR-EC

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

### 2. GENERALIDADES

Este manual está destinado a proporcionar al usuario una comprensión general de cómo funciona el equipo,

indicar las mejores formas de operarlo y la manera de cuidarlo para obtener una operación sin problemas. Sin

embargo, el usuario no debe tratar de realizar ningún tipo de reparación o calibración del equipo ya que

esto puede anular la garantía con el fabricante.

2.1. Condiciones de Operación.
- La temperatura ambiente debe estar entre 10°C a 40°C y una humedad relativa máxima del 80%.
- Opere el equipo únicamente de la forma descrita en este manual. Si el equipo se usa de una manera no

descrita en esta manual, la protección proporcionada por el equipo puede verse afectada.

- El equipo se debe utilizar en espacios interiores, igualmente debe estar almacenado en dichos espacios.

### 3. INSTRUCCIONES IMPORTANTES DE SEGURIDAD

Lea cuidadosamente las instrucciones de operación del equipo antes de iniciar cualquier operación.

a. Inspección de entrada

La cabina de flujo laminar PCR debe ser desempacada e inspeccionada para detectar daños mecánicos en la

recepción del mismo. Conserve el material de embalaje hasta que se finalice la inspección del equipo. La

inspección mecánica del equipo incluye revisar daños físicos como: superficies rayadas, superficies golpeadas,

entre otras.

Si se detecta algún daño aparente, contáctese con su distribuidor para que se notifique a fábrica y poder tramitar

el reclamo con el transportador correspondiente. Todos los productos de JP Inglobal son cuidadosamente

inspeccionados antes del envió y se toman todas las precauciones razonables al prepararlos para el envió, esto

con el fin de asegurar una llegada segura a su destino.

6

MANUAL DE USUARIO CABINA DE FLUJO LAMINAR PCR – JPCV36-PCR-EC

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

b. Garantía

JP Inglobal garantiza que este equipo está libre de defectos de material, mano de obra, componentes defectuosos

y montaje durante un año.

La garantía no incluye ni reemplaza el mantenimiento de rutina ni el mantenimiento preventivo que debe

realizarse de acuerdo a las instrucciones descritas durante el manual.

Nuestra obligación se limita a reemplazar el instrumento o las piezas después de una examinación del equipo, si

dentro del año a partir de la fecha de envió se demuestra algún defecto. Esta garantía no aplica a ningún

instrumento o componente que haya sido sometido a mal uso, negligencia, accidente, instalación o aplicación

incorrecta, ni se extenderá a Cabinas de flujo laminar que sean reparados o modificados fuera de fábrica sin previa

autorización.

La Cabina no debe usarse de una manera no descrita en este manual.

La empresa se reserva el derecho a garantía si la cabina se opera por fuera de los rangos de suministro eléctrico sugeridos por el fabricante.
La empresa se reserva el derecho a garantía si no se ejecutan los procedimientos de mantenimiento establecidos por el fabricante.
c. Declaración de Garantía

El registro de la garantía inicia automáticamente desde el día de despacho del equipo.

NOTA: Si existe alguna dificultad con el equipo y la solución no es cubierta por este manual, comuníquese con

nuestro representante o directamente con nosotros. No intente reparar el equipo por usted mismo. Trate de

describir el problema tan claro como sea posible para poder diagnosticar el mismo y proporcionar una pronta

solución. No se aceptarán Cabinas de flujo laminar para su reparación sin la debida autorización de nosotros.

7

MANUAL DE USUARIO CABINA DE FLUJO LAMINAR PCR – JPCV36-PCR-EC

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

d. Instrucciones de seguridad

Por favor lea y entienda las instrucciones de operación antes de la primera operación.

Asegúrese de saber en dónde se encuentra el interruptor de alimentación principal.

Equipamiento de protección, indumentaria y otras instrucciones de seguridad deben ser implementados de

acuerdo a las regulaciones locales y/o nacionales.

e. Instrucciones de operación-seguridad

Todos los usuarios del Cabina De flujo laminar PCR deben recibir capacitación en el uso adecuado de éste por

parte de un empleado experimentado. Todo empleado nuevo debe someterse a un período de capacitación a cargo

de un empleado experimentado.

Para la operación de la cabina se debe establecer un procedimiento escrito que incluya: pruebas diarias de

seguridad, verificación de filtro, accionamiento del motor, movimiento suave del sistema del vidrio, limpieza del

área de trabajo, prevención de corrosión, qué está permitido y qué está prohibido para el uso del equipo.

Antes de iniciar un proceso verifique que el ventilador se encuentra encendido.

Antes de operar la Luz UV asegúrese que la protección frontal este cerrada.

Examinar la condición de los ensambles regularmente. Asegurarse de que no haya filtraciones, roturas, bloqueos,

silbidos o ruidos extraños.

Las operaciones de mantenimiento se deben efectuar según las instrucciones.

Notificar inmediatamente a la persona a cargo sobre cualquier desviación o riesgo en el adecuado funcionamiento

del dispositivo.

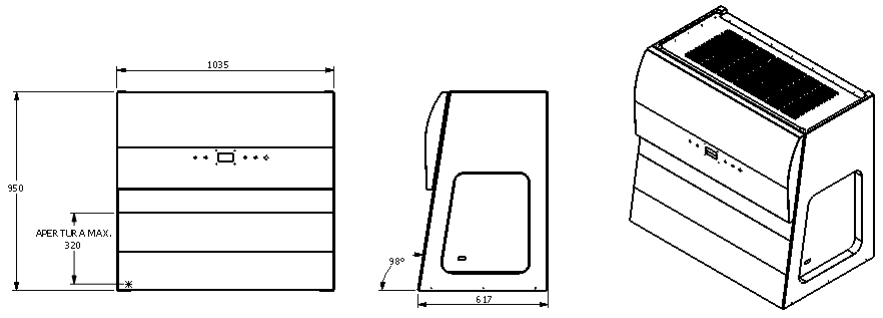
[picture p21: figure]

8

MANUAL DE USUARIO CABINA DE FLUJO LAMINAR PCR – JPCV36-PCR-EC

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

### 4. INSTALACIÓN

### 4.1. Locación Física

La superficie en la que ubique su Cabina De flujo laminar PCR debe ser lisa, nivelada y robusta. Asegúrese que

la superficie pueda soportar el peso del sistema y todos sus componentes.

También asegúrese de contar con espacio suficiente alrededor del equipo para un acceso apropiado para la

operación y mantenimiento.

Figura 1. Dimensiones en mm*.

*Las dimensiones varían de acuerdo al modelo escogido.

### 4.2. Ambiente

La Cabina De flujo laminar PCR opera adecuadamente bajo las siguientes condiciones:

- Rango de temperatura ambiente entre 10°C y 40°C.
- Humedad relativa por debajo de 80% sin condensación.

9

MANUAL DE USUARIO CABINA DE FLUJO LAMINAR PCR – JPCV36-PCR-EC

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

### 4.3. Servicios

Usando procedimientos estándar de operación y respetando todos los códigos aplicables, conecte los servicios a

sus respectivas conexiones, como se resume en la Tabla 1.

SERVICIO | REQUERIMIENTOS | CONEXIÓN
Electricidad | 110 VAC, 60 Hz, Monofásico (no exceder fluctuaciones +10%) | 110VAC: 1 Fase + Neutro + Tierra 15A

Tabla 1. Conexiones a servicios.

### 4.3.1. Requerimientos de electricidad

110 VAC | 60 Hertz | 15Amp

Tabla 2. Requerimientos de la red eléctrica.

¡PRECAUCIÓN!

Antes de realizar cualquier conexión eléctrica, verifique que el suministro de voltaje concuerde con

los requerimientos de poder mencionados y con los esquemas de control suministrados con la unidad.

¡ADVERTENCIA!

Se recomienda que la red eléctrica debe estar protegida con un relé de falla a tierra.

La red eléctrica debe cumplir con la normatividad y regulación local y/o nacional.

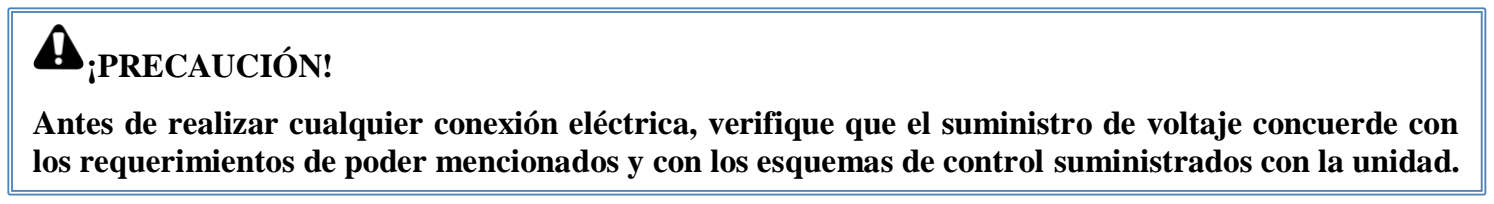
[picture p22: figure]
¡PRECAUCIÓN!

10

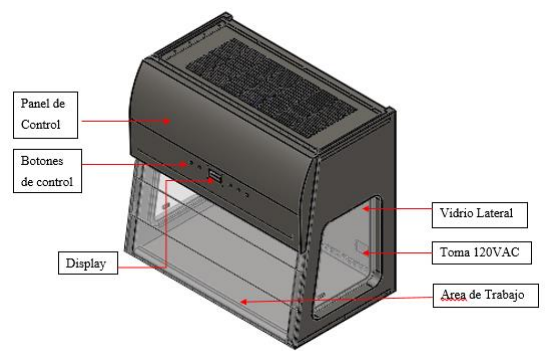
[picture p23: figure]

MANUAL DE USUARIO CABINA DE FLUJO LAMINAR PCR – JPCV36-PCR-EC

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

- Verifique que tenga un fácil acceso al switch (Breaker) principal de alimentación del equipo. Este breaker

debe estar marcado para una fácil identificación del mismo.

4.3.2. Instale su Cabina De flujo laminar PCR. Antes de instalar la cabina verifique las medidas del sitio de instalación. En la Figura 2, se detallan los

componentes de la Cabina De flujo laminar PCR.

Figura 2. Descripción de componentes.

* Los componentes de la cabina varían de acuerdo al modelo adquirido

Antes de realizar cualquier conexión eléctrica, verifique que el suministro de voltaje concuerde con los requerimientos de poder mencionados y con los esquemas de control suministrados con la unidad.

11

MANUAL DE USUARIO CABINA DE FLUJO LAMINAR PCR – JPCV36-PCR-EC

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

### 5. ESPECIFICACIONES

Cabina de flujo laminar PCR

Área de trabajo | Material | Acero inoxidable 304
| Apertura de operación | 32cm
Sistema de control | Visualizador | Pantalla GLCD 128x64 pixeles
| Función | Monitoreo de elementos principales de la cabina
Temperatura | Indicación | Pantalla GLCD incrementos en 1°C
| Rango | 2°C a 150°C
| Sensor | LM35
Presión | Indicación | Pantalla GLCD en saturación de filtro
| Sensor | Presión diferencial MPXV5004DP
Requerimientos Eléctricos | 110 V | 60 Hertz | Monofásico: 1 Fase +Neutro + Tierra | 15A
Dimensiones Exteriores en mm (Alto X Ancho X Fondo) | | 950mm X 1035mm X 617mm
Peso neto | | 60 Kg

12

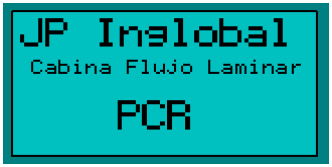
[picture p24: figure]

MANUAL DE USUARIO CABINA DE FLUJO LAMINAR PCR – JPCV36-PCR-EC

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

### 6. OPERACIÓN DE CONTROLES

La Cabina De flujo laminar PCR permite al usuario monitorear los componentes que influyen en el funcionamiento de la cabina. Entre estos están:

- Estado de Luz Blanca.
- Estado de Motor.
- Estado luz UV
- Temporizador UV
- Saturación del filtro.
- Temperatura (C°).
- Velocidad del motor (1 a 6).

El monitoreo de los parámetros mencionados anteriormente permiten al usuario verificar constantemente el funcionamiento de la cabina de flujo laminar PCR.

Para encender la cabina conecte el cable de poder a un tomacorriente (ver sección 4.3.1) y enciéndala ubicando el switch ON/OFF en la posición ON. Una vez encendido el equipo el Display deberá mostrar el mensaje que se muestra en la Figura 3. Esto indicara que se conectó correctamente, de lo contrario verifique nuevamente las conexiones.

Figura 3.Mensaje inicial.

6.1.Teclado

El teclado de la Cabina De flujo laminar PCR cuenta hasta con dos opciones dependiendo de la tecla.

13

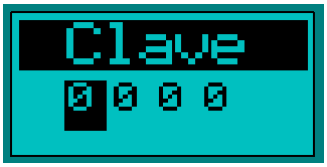
[picture p25: figure]

MANUAL DE USUARIO CABINA DE FLUJO LAMINAR PCR – JPCV36-PCR-EC

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

Cuando el Display se encuentra en la pantalla principal (ver Figura 8) el teclado tiene las siguientes características:

- Menú\↑: Sirve para acceder al Menú de configuraciones de la cabina de flujo laminar PCR.
- Luz\↓: Modifica el estado de la Luz Blanca interna del equipo (ON/OFF)*.
- Motor\→: Modifica el estado del motor (ON/OFF)*.
- Luz UV\←: Modifica el estado de la luz UV (ON/OFF)*, Retroceso.

*Varían en función de la posición de la protección frontal.

6.2.Contraseña de Acceso

Esta opción permite que solo el operador que tenga conocimiento de la clave de acceso a la cabina pueda manipularla. Evitando que personas no capacitadas manipulen la Cabina De flujo laminar PCR.

Para mover el cursor de unidad utilice la tecla →.
Para modificar el valor de la unidad donde se encuentra el cursor utilice las teclas ↑ ó ↓ como se muestra en la Figura 4.

Figura 4. Contraseña de acceso.

Una vez ubicado el cursor en la última unidad de Izquierda a Derecha, oprima la tecla → para continuar. Si la contraseña ingresada es incorrecta se mostrara el mensaje de la Figura 5. De lo contrario se mostrara el mensaje de la Figura 6.

14

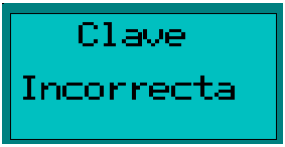
[picture p26: figure]
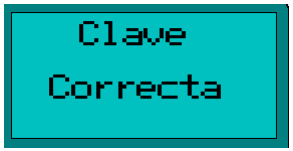
[picture p27: figure]
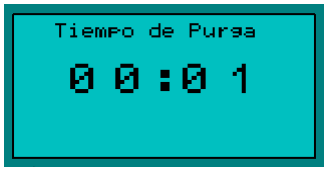
[picture p28: figure]

MANUAL DE USUARIO CABINA DE FLUJO LAMINAR PCR – JPCV36-PCR-EC

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

Figura 5.Contraseña incorrecta.

Figura 6.Contraseña correcta.

6.3.Tiempo de Purga

Una vez ingresada correctamente la contraseña de acceso, se ejecutara el tiempo de purga programada, el cual como su nombre lo indica, realiza una purga en el aire que exista en el área de trabajo, con el fin de garantizar una zona segura en el área de trabajo de la cabina.

Figura 7. Tiempo de purga.

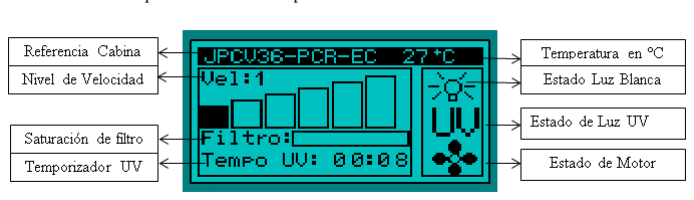
[picture p29: figure]

15

MANUAL DE USUARIO CABINA DE FLUJO LAMINAR PCR – JPCV36-PCR-EC

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

6.4.Menú de Visualización de estados

Una vez haya finalizado el tiempo de purga, se mostrara la pantalla de la Figura 8. Automáticamente se encenderá la Luz Blanca indicando que la cabina esta lista para ser utilizada.

Figura 8. Pantalla principal.

6.5.Menú Principal

Este Menú permite configurar opciones como:
- Ajustes
- Tiempo de purga
- Temporizador UV
- Clave
- Modo
- Mantenimiento
- Servicio

### 6.5.1. Ajustes

Para acceder a este menú ubique el cursor en la sección de ajustes, utilizando las teclas ↑ ó ↓ según sea necesario. Una vez ubicado el cursor oprima la tecla → para acceder a los ajustes.

16

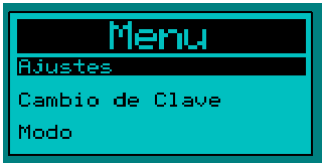
[picture p30: figure]
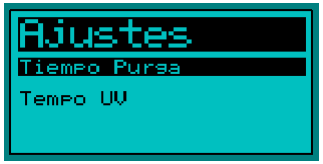
[picture p31: figure]
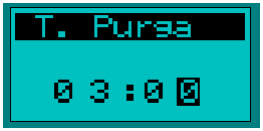
[picture p32: figure]

MANUAL DE USUARIO CABINA DE FLUJO LAMINAR PCR – JPCV36-PCR-EC

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

Figura 9. Acceso a ajustes.

6.5.1.1.Tiempo de purga

Para acceder a este menú ubique el cursor en la sección de Tiempo de Purga, utilizando las teclas ↑ o ↓ según sea necesario. Una vez ubicado el cursor oprima la tecla → para acceder al menú de Tiempo de Purga.

Figura 10. Tiempo de purga.

Para modificar la unidad seleccionada utilice las teclas ↑ o ↓ según sea necesario. Para cambiar de unidad utilice la tecla →.
Para salir de este menú almacenando el valor configurado oprima la tecla ←.

Figura 11. Menú tiempo de purga.

17

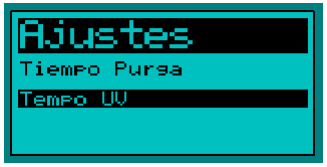
[picture p33: figure]
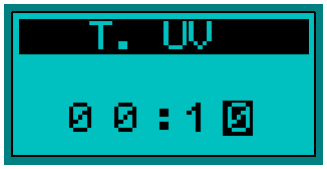
[picture p34: figure]

MANUAL DE USUARIO CABINA DE FLUJO LAMINAR PCR – JPCV36-PCR-EC

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

### 6.5.1.2. Temporizador UV

Para acceder a este menú ubique el cursor en la sección de Tempo UV, utilizando las teclas ↑ o ↓ según sea necesario. Una vez ubicado el cursor oprima la tecla → para acceder al menú del Temporizador UV.

Figura 12. Temporizador UV.

Para modificar la unidad seleccionada utilice las teclas ↑ o ↓ según sea necesario. Para cambiar de unidad utilice la tecla →.
Para salir de este menú almacenando el valor configurado oprima la tecla ←.

Figura 13. Menú de temporizador UV.

### 6.5.2. Clave

Este menú permite al usuario modificar la contraseña que trae el equipo por defecto.

Para acceder a este menú ubique el cursor en la sección de Clave, utilizando las teclas ↑ o ↓ según sea necesario. Una vez ubicado el cursor oprima la tecla → para acceder este Menú.

18

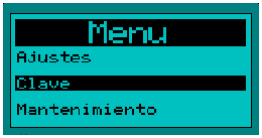
[picture p35: figure]
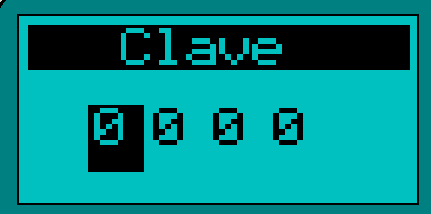
[picture p36: figure]
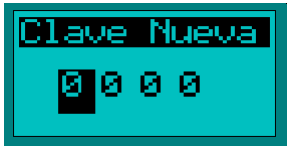
[picture p37: figure]

MANUAL DE USUARIO CABINA DE FLUJO LAMINAR PCR – JPCV36-PCR-EC

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

Figura 14. Clave.

A continuación le solicitara ingresar la contraseña actual. Para mover el cursor de unidad utilice la tecla →.Para modificar el valor de la unidad donde se encuentra el cursor utilice las teclas ↑ o ↓.

Figura 15.Contraseña de acceso.

Una vez ubicado el cursor en la última unidad de Izquierda a Derecha, oprima la tecla → para continuar.

Si la contraseña ingresada es incorrecta se mostrara el mensaje de la Figura 5 y volverá al Menú principal. De lo contrario se mostrara el mensaje de la figura 6 y le solicitara ingresar la contraseña nueva (ver Figura 16).

Figura 16. Clave nueva.

Una vez ubicado el cursor en la última unidad de Izquierda a Derecha, oprima la tecla → para almacenar la nueva clave.

19

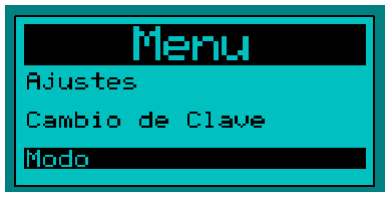
[picture p38: figure]
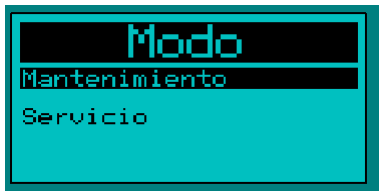
[picture p39: figure]

MANUAL DE USUARIO CABINA DE FLUJO LAMINAR PCR – JPCV36-PCR-EC

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

### 6.5.3. Modo

### 6.5.3.1. Mantenimiento

Este menú fue implementado para que el usuario pueda realizar la limpieza de la cabina.
Para acceder a este menú ubique el cursor en la sección de modo, utilizando las teclas ↑ o ↓ según sea necesario. Una vez ubicado el cursor oprima la tecla → para acceder este Menú.

Figura 17. Pantalla en menú.

En la sección de modo, utilizando las teclas ↑ o ↓ según sea necesario ubique la sección mantenimiento. Una vez ubicado el cursor oprima la tecla → para acceder este Menú.

Figura 18.Sección de modo.

En esta sección se podrá ver el trabajo del filtro en horas, también se podrá observar el trabajo de luz UV en horas de uso, además de esto la luz blanca permanecerá encendida para realizar la limpieza de la cabina y/o mantenimiento de la misma.

20

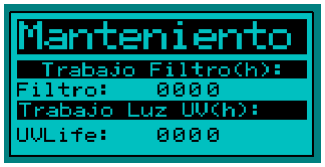
[picture p40: figure]

MANUAL DE USUARIO CABINA DE FLUJO LAMINAR PCR – JPCV36-PCR-EC

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

Figura 19. Modo Mantenimiento.

6.5.3.2.Servicio

Este menú es utilizado únicamente por el fabricante. Para mayor información contáctese con el departamento técnico de JP Inglobal en la ciudad de Bogotá (Colombia).

21

MANUAL DE USUARIO CABINA DE FLUJO LAMINAR PCR – JPCV36-PCR-EC

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

### 7. NORMATIVIDAD DE BIOSEGURIDAD

Normas de seguridad de la OSHA

- No coma, beba, fume, aplique cosmético, ni use lentes de contacto en áreas de exposición.
- Limpie los derrames de sangre o fluidos corporales rápidamente, siguiendo el procedimiento establecido para tal fin.
- Coloque la ropa contaminada en una bolsa impermeable y amárrela fuertemente.
- Limpie, desinfecte o esterilice el equipo contaminado entre usos y antes de enviarlo para revisión o reparación.
- Reporte inmediatamente cualquier accidente con sangre o fluidos corporales y tome las medidas necesarias preventivas y correctivas.
- Dependiendo del caso, siga las medidas de aislamiento establecidas.
- Mantenga el lugar de trabajo en óptimas condiciones de higiene y aseo.
- No guarde alimentos en neveras ni en los equipos de refrigeración de sustancias contaminantes o químicas.
- No deambule con los elementos de protección personal fuera de su área de trabajo.
- Mantenga sus elementos de protección personal en óptimas condiciones de aseo, en un lugar seguro y de fácil acceso.
- Restringir el ingreso a las áreas de alto riesgo a personal no autorizado.
- Esquema de inmunización completo, especial énfasis en hepatitis B y tétanos.

22

MANUAL DE USUARIO CABINA DE FLUJO LAMINAR PCR – JPCV36-PCR-EC

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

### 8. LIMPIEZA

8.1.Limpieza de Zona de Trabajo

Si aplica, asegúrese de seguir las regulaciones de bioseguridad, respecto a la liberación de

microorganismos al medio ambiente.

1. Humedezca un paño con una solución de detergente leve y agua destilada.
2. Limpie con el paño todas las áreas en las que se observe suciedad. Úselo en todas las superficies internas.
3. Con un paño seco, realice el secado de la cabina.

8.2.Limpieza de componentes externos de la Cabina de flujo laminar PCR

Al menos una vez al mes, limpie todas las partes plásticas y metálicas de la unidad. Use un paño suave humedecido

con agua o detergente leve. Si se usa detergente, remueva todo el residuo enjuagándolo con agua limpia.

Asegúrese que elementos húmedos no entren en contacto con los componentes electrónicos del equipo (Display,

Pulsadores) ya que puede afectar su funcionamiento e invalidar la garantía de los mismos.

¡PRECAUCIÓN!
Nunca limpie la cámara o los componentes externos de la Cabina De flujo laminar PCR con químicos o materiales abrasivos.

¡ADVERTENCIA!
Siempre apague su Cabina De flujo laminar PCR y desconecte el cable de poder antes de realizar cualquier tipo de Limpieza.

23

MANUAL DE USUARIO CABINA DE FLUJO LAMINAR PCR – JPCV36-PCR-EC

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

### 9. MANTENIMIENTO

El mantenimiento productivo total (TPM), mantiene en condiciones óptimas de trabajo el buen funcionamiento

del equipo, cuando este se realiza de forma estricta, el funcionamiento del equipo es óptimo y útil.

El propietario es responsable de instruir al operador sobre las técnicas del TPM y así mismo solicitar un técnico

capacitado para realización de intervención de alta complejidad del equipo.

En el mantenimiento preventivo se realiza una revisión de los equipos y remplazo o reparación de aquellas partes

que por su estado podrían generar productos no satisfactorios. Este tipo de mantenimiento permite que el equipo

opere en condiciones adecuadas de trabajo. Cuando se realiza rutinariamente, el mantenimiento resulta en una

vida útil más larga para su equipo. También reduce pérdida de tiempo por interrupciones debido a fallas del

equipo.

Es obligación de la entidad que adquirió el equipo seguir realizando los mantenimientos del equipo con sus

respectivos registros, después de cumplido el periodo de garantía del equipo.

Los equipos deben adaptarse, ubicarse y mantenerse en un espacio donde el riesgo de error y contaminación sea

mínimo.

¡ADVERTENCIA!
Siempre apague su Cabina De flujo laminar PCR y desconecte el cable de poder antes de realizar el mantenimiento.

24

MANUAL DE USUARIO CABINA DE FLUJO LAMINAR PCR – JPCV36-PCR-EC

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

9.1.Mantenimiento Semanal

Retire todo lo que se encuentre dentro de la cabina y realice la limpieza que establece en la sección 8.1.

Está prohibido utilizar elementos húmedos en el panel de control, ya que pueden afectar el funcionamiento del

Display y demás componentes.

9.2.Mantenimiento Mensual

Retire todo lo que se encuentre al interior de la cabina de flujo laminar PCR y realice una limpieza profunda tanto interna como externa de la cabina como se describe en la sección 8.

Inspeccione puntos de soldadura para verificar que no halla grietas que puedan ocasionar desprendimiento.

Revise el estado mecánico de los botones y el funcionamiento del display.

### 9.3. Mantenimiento Anual

Verifique y ajuste todas las conexiones de tornillo en la caja de control.

Verifique el estado del filtro, de ser necesario reemplacelo.

Inspeccione puntos de soldadura para verificar que no halla grietas que puedan ocasionar desprendimiento.

Revise que el vidrio de la cabina no tenga grietas y tampoco este siendo forzado en su desplazamiento

¡ADVERTENCIA!

No utilice materiales abrasivos como esponjas de acero o cepillos de acero ya que pueden dañar la cámara.

¡ADVERTENCIA!

No utilice materiales abrasivos como esponjas de acero o cepillos de acero ya que pueden dañar la cámara.

25

MANUAL DE USUARIO CABINA DE FLUJO LAMINAR PCR – JPCV36-PCR-EC

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

Revise el estado mecánico de los botones y el funcionamiento del display.

Realice la verificación del estado de las luces UV.

Realice la verificación del flujo laminar del equipo.

Realice la verificación de la intensidad lumínica de las lámparas LED.

9.4.Mantenimiento de sistemas Eléctricos y Electrónicos.

Una vez al año para mantener la integridad del sistema eléctrico y electrónico, se debe realizar la inspección de

todos los sistemas eléctricos y electrónicos de la Cabina de flujo laminar PCR, ya que son de vital importancia en

el funcionamiento de esta. Además de realizar un monitoreo en la lectura de la temperatura, de forma que se

mantengan los rangos de funcionamiento establecidos por el fabricante.

Dentro de los sistemas a revisar se destacan:

- Sistemas de protección contra cortocircuitos (Breakers, Fusibles).
- Elementos de potencia (Contactor, Guardamotor).
- Sistema de control electrónico (PCB).

¡ADVERTENCIA!

Nunca trate de realizar este mantenimiento usted mismo, contrate personal calificado para este servicio y tenga en cuenta las cláusulas de garantía del equipo.

¡ADVERTENCIA!

Siempre apague su Cabina De flujo laminar PCR y desconecte el cable de poder antes de realizar cualquier mantenimiento.

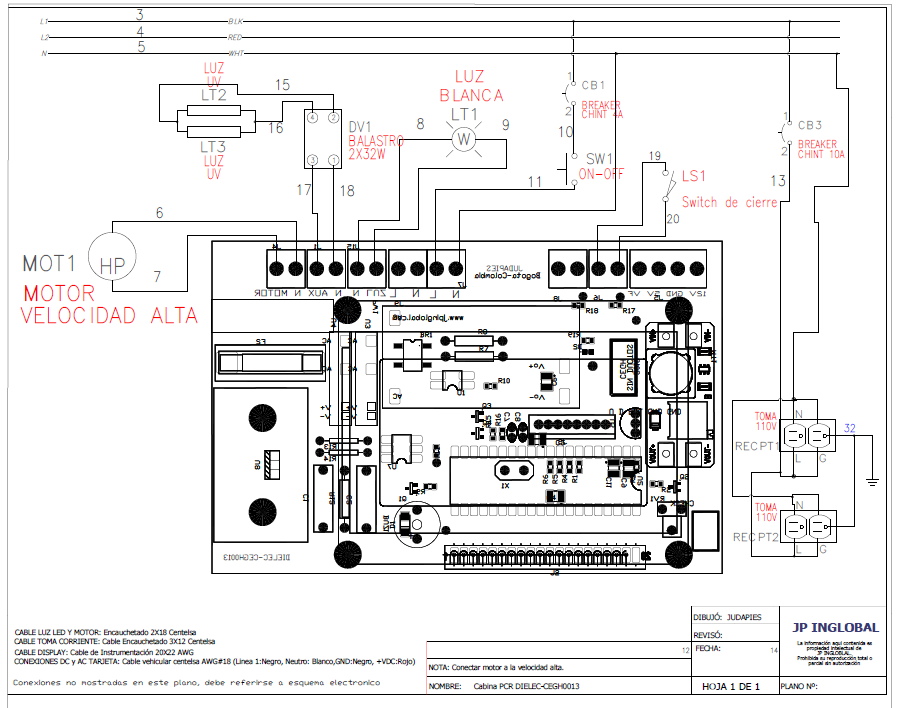
[picture p41: figure]

26

MANUAL DE USUARIO CABINA DE FLUJO LAMINAR PCR – JPCV36-PCR-EC

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

### 9.4.1. Esquema Eléctrico y Electrónico

27

MANUAL DE USUARIO CABINA DE FLUJO LAMINAR PCR – JPCV36-PCR-EC

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

### 10. SERVICIO

Si ocurre cualquier problema con el sistema de su Cabina De flujo laminar PCR o sus componentes individuales,

no intente realizar ningún arreglo. Servicio no autorizado puede invalidar la garantía. Por favor contacte el

departamento de servicio de JP Inglobal.

En cualquier comunicación con JP Inglobal por favor refiérase al número del modelo, el número de fabricación

de las partes y el número de serial de la unidad.

### 10.1. Solución de problemas

Como con cualquier equipo, a veces se presentan dificultades. Si experimenta algún problema con la operación

de su Cabina De flujo laminar PCR consulte la siguiente lista de síntomas. Puede ser capaz de resolver la situación

usted mismo de manera fácil y rápida.

Si el problema no se encuentra en la lista, o si las soluciones sugeridas no funcionan, por favor comuníquese con

el centro de servicio de JP Inglobal. Aparte de las soluciones propuestas a continuación, no intente arreglar el

equipo usted mismo.

¡ADVERTENCIA!

Siempre apague su Cabina De flujo laminar PCR y desconecte el cable de poder antes de realizar cualquier mantenimiento.

28

MANUAL DE USUARIO CABINA DE FLUJO LAMINAR PCR – JPCV36-PCR-EC

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

no sea el buen uso del equipo. Dudas o sugerencias, favor escribir a: servicioalcliente@jpinglobal.com y/o | o comunicarse al Teléfono: +57 (1) 756-8668 / Cel.
Problema | Posible solución
El Display está en blanco | •Espere un minuto, ya que el Display se refresca cada minuto, de persistir el problema, oprima la tecla reset y encienda nuevamente la cabina.
La cabina no enciende | •Verifique que el suministro eléctrico este dentro de los rangos establecidos. •Verifique que el equipo esté conectado correctamente al suministro eléctrico.
En el Display se observan caracteres extraños | •Espere a que la cabina refresque la pantalla, si el problema persiste reinicie la cabina.
El motor no enciende | •Verifique que el suministro eléctrico este dentro de los rangos establecidos. •Verifique que la velocidad seleccionada este como mínimo en la velocidad 1.
Luz UV no enciende | •Verifique que la protección frontal del equipo este ubicada correctamente en la cabina •Revise que el sensor magnético si este en el lugar indicado de la protección frontal.

29

MANUAL DE USUARIO CABINA DE FLUJO LAMINAR PCR – JPCV36-PCR-EC

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

propósito que no sea el buen uso del equipo. Dudas o sugerencias, favor escribir a: servicioalcliente@jpinglobal.com y/o o comunicarse al Teléfono: +57 (1)

756-8668 / Cel. +57 (1) 316-464-3827

### 11. CLAUSULA EXONERATIVA DE RESPONSABILIDAD

La empresa JP INGLOBAL no se hace responsable de daños ocasionados por manipulación indebida e

incumplimiento de los procedimientos señalados en este manual.

Así mismo, se excluye de toda responsabilidad por daños derivados por empleo de sustancias no

compatibles con el equipo y hacer caso omiso a las indicaciones aquí señaladas.

Esta garantía NO aplica si el daño es causado por incendio, accidente, uso incorrecto, descuido, ajuste o

reparación incorrecta, o daño causado por la instalación, adaptación, modificación, colocación de piezas no

aprobadas o reparaciones realizadas por personal no autorizado.

Esta garantía NO aplica si los sellos de seguridad se encuentran rotos o han sido violentados.

Por lo anterior se solicita a cada una de las personas que manipule este equipo, tenga conocimiento previo

de este manual y siga las indicaciones que fueron cuidadosamente preparadas, para obtener el máximo

provecho del equipo y evitar que se causen daños.

Cualquier inquietud acerca del equipo comuníquese con nosotros a:

JP BIOINGENIERIA SAS

Fabricación de equipos biomédicos y psicológicos

comercialjp@jpinglobal.com

Tel. +57 (1) 7568668

Av. Calle 80 # 69P - 07 / Bogotá – Colombia

www.jpinglobal.com
