judapies/Cabina-PCR/(list of files, drawings)

Other design files:
2015/Microvet/Schematic/Cabina_PCR.DSN
2015/Microvet/Schematic/Cabina_PCR.LYT
2017/60/Cabina Avantika #004587687/Schematic/Cabina_PCR.DSN
2017/60/Cabina Avantika #004587687/Schematic/Cabina_PCR.LYT
2017/60/Cabina Punto Clinico #004587647/Schematic/Cabina_PCR.DSN
2017/60/Cabina Punto Clinico #004587647/Schematic/Cabina_PCR.LYT
2019/CPCR60 GLCD Avantika #004588033-40 OP2019156-161_181-182/Schematic/CFLGLCD.pdsprj
2019/CPCR90 GLCD Artilab #004587996 OP2019116/Schematic/CFLGLCD.pdsprj
2019/CPCR 90 Artilab #004587978 OP201988/Schematic/Cabina_PCR.DSN
2019/CPCR 90 Artilab #004587978 OP201988/Schematic/Cabina_PCR.LYT
2019/CPCR 90 Artilab #004587987 OP201994/Schematic/Cabina_PCR.DSN
2019/CPCR 90 Artilab #004587987 OP201994/Schematic/Cabina_PCR.LYT
2019/CPCR 90 Universidad Nariño LCD4X20 #004588059 OP2019205/Schematic/AcopleFuente.pdsprj
2019/CPCR 90 Universidad Nariño LCD4X20 #004588059 OP2019205/Schematic/CabinaCFLH-V-D4X20.pdsprj
2020/CPCR60 GLCD Avantika #004588100 OP202044/Schematic/CFLGLCD.pdsprj
2020/CPCR60 GLCD Avantika #004588101 OP202045/Schematic/CFLGLCD.pdsprj
2020/CPCR60 GLCD Avantika #004588102 OP202046/Schematic/CFLGLCD.pdsprj
2020/CPCR60 GLCD Avantika #004588103 OP202047/Schematic/CFLGLCD.pdsprj
2020/CPCR60 GLCD CEMMIT #004588404 OP2020359/Schematic/CFLGLCD.pdsprj
2020/CPCR60 GLCD Laboratorio Clinico Kheneyder Fayad #004588294 OP2020276/Schematic/CFLGLCD.pdsprj
2020/CPCR90 GLCD Artilab #004588091 OP2019199/Schematic/CFLGLCD.pdsprj
2020/CPCR90 GLCD Avantika #004588183 OP2020140/Schematic/CFLGLCD.pdsprj
2020/CPCR90 GLCD Avantika #004588186-87 OP2020154-155/Schematic/CFLGLCD.pdsprj
2020/CPCR90 GLCD Avantika #004588212 OP2020170/Schematic/CFLGLCD.pdsprj
2020/CPCR90 GLCD Avantika #004588258 OP2020211/Schematic/CFLGLCD.pdsprj
2020/CPCR90 GLCD Biodiz Peru #004588195 OP2020149/Schematic/CFLGLCD.pdsprj
2020/CPCR90 GLCD Biodiz Peru #004588196 OP2020150/Schematic/CFLGLCD.pdsprj
2020/CPCR90 GLCD Biodiz Peru #004588396 OP2020356/Schematic/CFLGLCD.pdsprj
2020/CPCR90 GLCD CEMMIT #004588354 OP2020304/Schematic/CFLGLCD.pdsprj
2020/CPCR90 GLCD Ghesminne Ortega Peru #004588231 OP2020195/Schematic/CFLGLCD.pdsprj
2020/CPCR90 GLCD Sin Cliente #0045883XX OP2020XXX/Schematic/CFLGLCD.pdsprj
2020/CPCR180 GLCD Diagnostic Medical Lab #004588393 OP2020308/Schematic/CFLGLCD.pdsprj
2020/CPCR 48 Laboratorio Garcia Beltran LCD4X20 #004588177 OP202083/Schematic/AcopleFuente.pdsprj
2020/CPCR 48 Laboratorio Garcia Beltran LCD4X20 #004588177 OP202083/Schematic/CabinaCFLH-V-D4X20.pdsprj
2020/CPCR Trabajo Annar D4X20 #0045882XX-XX-XX-XX-XX OP2020265-266-267-268-269/Schematic/AcopleFuente.pdsprj
2020/CPCR Trabajo Annar D4X20 #0045882XX-XX-XX-XX-XX OP2020265-266-267-268-269/Schematic/CabinaCFLHV-D4X20_VE.pdsprj
2020/CPCR Trabajo Annar D4X20 #004588213-14-36-37 OP2020200-203/Schematic/AcopleFuente.pdsprj
2020/CPCR Trabajo Annar D4X20 #004588213-14-36-37 OP2020200-203/Schematic/Cabina_PCR.DSN
2020/CPCR Trabajo Annar D4X20 #004588213-14-36-37 OP2020200-203/Schematic/CabinaCFLH-V-D4X20.pdsprj
2020/CPCR Trabajo Annar D4X20 #004588267-68-69-70-71-72-73 OP2020231-232-233-234-235-244-245/Schematic/AcopleFuente.pdsprj
2020/CPCR Trabajo Annar D4X20 #004588267-68-69-70-71-72-73 OP2020231-232-233-234-235-244-245/Schematic/CabinaCFLHV-D4X20_VE.pdsprj
2020/CPCR Trabajo Artilab D4X20 #004588179 OP2020157/Schematic/AcopleFuente.pdsprj
2020/CPCR Trabajo Artilab D4X20 #004588179 OP2020157/Schematic/Cabina_PCR.DSN
2020/CPCR Trabajo Artilab D4X20 #004588179 OP2020157/Schematic/CabinaCFLH-V-D4X20.pdsprj
2020/CPCR Trabajo Avantika D4X20 #0045882XX-XX OP2020226-227/Schematic/AcopleFuente.pdsprj
2020/CPCR Trabajo Avantika D4X20 #0045882XX-XX OP2020226-227/Schematic/CabinaCFLHV-D4X20_VE.pdsprj
2020/CPCR Trabajo Avantika D4X20 #004588337-48 OP2020305-306/Schematic/AcopleFuente.pdsprj
2020/CPCR Trabajo Avantika D4X20 #004588337-48 OP2020305-306/Schematic/CabinaCFLHV-D4X20_VE.pdsprj
2020/CPCR Trabajo Biodiz D4X20 #004588392 OP2020357/Schematic/AcopleFuente.pdsprj
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
